Even-lwx/Triple-1S-Battery-Charger/code/connectivity-check.md

# 连通性复核

解析器版本 1：读取 Altium OLE 记录、原理图 RECORD=27 导线，以及 PCB Pads6 二进制网络/元件引用。
这里只使用单页整数几何关系。PCB 结果仅用于独立复核焊盘和网络，电气功能仍需结合芯片数据手册确认。

- U2.1 PC13: 原理图=PC13; PCB=PC13; 一致; UID=YJEDCGPU
- U2.2 PC14-OSC32_IN: 原理图=unnamed; PCB=未连接; 未命名; UID=EMMYZKTZ
- U2.3 PC15-OSC32_OUT: 原理图=unnamed; PCB=未连接; 未命名; UID=YTNMWNVS
- U2.4 VBAT: 原理图=3V3; PCB=3V3; 一致; UID=XNZBAPYZ
- U2.5 VREF+: 原理图=3V3; PCB=3V3; 一致; UID=BXHLKROT
- U2.6 VDD/VDDA: 原理图=3V3; PCB=3V3; 一致; UID=DLKCWMLF
- U2.7 VSS/VSSA: 原理图=GND; PCB=GND; 一致; UID=IMOANLTL
- U2.8 PF0-OSC_IN: 原理图=unnamed; PCB=NetC5_1; 未命名; UID=NLGOGNUO
- U2.9 PF1-OSC_OUT: 原理图=unnamed; PCB=NetC10_2; 未命名; UID=NNXCCHOH
- U2.10 PF2-NRST: 原理图=NRST; PCB=NRST; 一致; UID=FTIKCTVL
- U2.11 PA0: 原理图=ADC1_IN0; PCB=ADC1_IN0; 一致; UID=BTTNBYLP
- U2.12 PA1: 原理图=ADC1_IN1; PCB=ADC1_IN1; 一致; UID=DWYZLZNQ
- U2.13 PA2: 原理图=ADC1_IN2; PCB=ADC1_IN2; 一致; UID=QWPJPJDA
- U2.14 PA3: 原理图=ADC1_IN3; PCB=ADC1_IN3; 一致; UID=YGVUCJJT
- U2.15 PA4: 原理图=ADC1_IN4; PCB=ADC1_IN4; 一致; UID=QVMMUHNP
- U2.16 PA5: 原理图=ADC1_IN5; PCB=ADC1_IN5; 一致; UID=BHYGJPWF
- U2.17 PA6: 原理图=ADC1_IN6; PCB=ADC1_IN6; 一致; UID=GSTGELWS
- U2.18 PA7: 原理图=ADC1_IN7; PCB=ADC1_IN7; 一致; UID=QSPUCRNU
- U2.19 PB0: 原理图=unnamed; PCB=未连接; 未命名; UID=MEIPMAVJ
- U2.20 PB1: 原理图=unnamed; PCB=未连接; 未命名; UID=IZIHLWRI
- U2.21 PB2: 原理图=unnamed; PCB=未连接; 未命名; UID=KPNJPDPE
- U2.22 PB10: 原理图=PB10; PCB=PB10; 一致; UID=ZUVCRTMJ
- U2.23 PB11: 原理图=PB11; PCB=PB11; 一致; UID=TDTFGGSF
- U2.24 PB12: 原理图=PB12; PCB=PB12; 一致; UID=XKXEDOHT
- U2.25 PB13: 原理图=PB13; PCB=PB13; 一致; UID=AGJNDDFJ
- U2.26 PB14: 原理图=PB14; PCB=PB14; 一致; UID=OEQSESRP
- U2.27 PB15: 原理图=PB15; PCB=PB15; 一致; UID=NZOHDMBE
- U2.28 PA8: 原理图=unnamed; PCB=未连接; 未命名; UID=WIMFFKBL
- U2.29 PA9: 原理图=USART1_TX; PCB=USART1_TX; 一致; UID=NCBLJZFQ
- U2.30 PC6: 原理图=unnamed; PCB=未连接; 未命名; UID=YKQCQAAE
- U2.31 PC7: 原理图=unnamed; PCB=未连接; 未命名; UID=SIREAZQO
- U2.32 PA10: 原理图=USART1_RX; PCB=USART1_RX; 一致; UID=EFQVRADD
- U2.33 PA11[PA9]: 原理图=SPI1_MISO; PCB=SPI1_MISO; 一致; UID=DEECQGFN
- U2.34 PA12[PA10]: 原理图=SPI1_MOSI; PCB=SPI1_MOSI; 一致; UID=TXISVZNW
- U2.35 PA13: 原理图=SWDIO; PCB=SWDIO; 一致; UID=HHMXTXLN
- U2.36 PA14-BOOT0: 原理图=SWCLK; PCB=SWCLK; 一致; UID=LNGEJKZY
- U2.37 PA15: 原理图=unnamed; PCB=未连接; 未命名; UID=HMZLWYNL
- U2.38 PD0: 原理图=unnamed; PCB=未连接; 未命名; UID=CDKCRYSF
- U2.39 PD1: 原理图=PD1; PCB=PD1; 一致; UID=RTOJNFKF
- U2.40 PD2: 原理图=PD2; PCB=PD2; 一致; UID=TRQDABEJ
- U2.41 PD3: 原理图=PD3; PCB=PD3; 一致; UID=YJKJACAJ
- U2.42 PB3: 原理图=SPI1_SCK; PCB=SPI1_SCK; 一致; UID=TBVPMIWN
- U2.43 PB4: 原理图=PB4; PCB=PB4; 一致; UID=UAMPWPLB
- U2.44 PB5: 原理图=PB5; PCB=PB5; 一致; UID=CTSFHKLA
- U2.45 PB6: 原理图=PB6; PCB=PB6; 一致; UID=ZBDHNJFP
- U2.46 PB7: 原理图=PB7; PCB=PB7; 一致; UID=TEQMKVTK
- U2.47 PB8: 原理图=PB8; PCB=PB8; 一致; UID=UDJZPONJ
- U2.48 PB9: 原理图=PB9; PCB=PB9; 一致; UID=YJGGJVBI
- U5.1 IN: 原理图=5V_1; PCB=5V_1; 一致; UID=FEXVTGQE
- U5.2 ISET: 原理图=unnamed; PCB=NetR20_2; 未命名; UID=WSPMRYCQ
- U5.3 VSS: 原理图=GND; PCB=GND; 一致; UID=QGELADCW
- U5.4 PRETERM: 原理图=unnamed; PCB=NetR19_2; 未命名; UID=XNBEBDPG
- U5.5 PG#: 原理图=unnamed; PCB=NetLED1_1; 未命名; UID=PPBXFOSY
- U5.6 NC: 原理图=unnamed; PCB=未连接; 未命名; UID=SQTLGJFR
- U5.7 ISET2: 原理图=PB10; PCB=PB10; 一致; UID=BYBYBBMB
- U5.8 CHG#: 原理图=unnamed; PCB=NetLED3_1; 未命名; UID=CAYGFLDT
- U5.9 TS: 原理图=unnamed; PCB=NetR12_1; 未命名; UID=CIXCXFLB
- U5.10 OUT: 原理图=VBAT1_H; PCB=VBAT1_H; 一致; UID=NFSJJRQO
- U5.11 EP: 原理图=GND; PCB=GND; 一致; UID=HKDDBQFO
- U7.1 IN: 原理图=5V_2; PCB=5V_2; 一致; UID=OHIXYFKE
- U7.2 ISET: 原理图=unnamed; PCB=NetR37_2; 未命名; UID=HQWBLRSN
- U7.3 VSS: 原理图=GND; PCB=GND; 一致; UID=KROUAISZ
- U7.4 PRETERM: 原理图=unnamed; PCB=NetR36_2; 未命名; UID=KYNVKFRO
- U7.5 PG#: 原理图=unnamed; PCB=NetLED7_1; 未命名; UID=TOYUEIHO
- U7.6 NC: 原理图=unnamed; PCB=未连接; 未命名; UID=KDYSISUF
- U7.7 ISET2: 原理图=PB11; PCB=PB11; 一致; UID=ACEJQXMG
- U7.8 CHG#: 原理图=unnamed; PCB=NetLED8_1; 未命名; UID=PINZSOUC
- U7.9 TS: 原理图=unnamed; PCB=NetR31_1; 未命名; UID=YHHWTXJB
- U7.10 OUT: 原理图=VBAT2_H; PCB=VBAT2_H; 一致; UID=KZJXJZRR
- U7.11 EP: 原理图=GND; PCB=GND; 一致; UID=EHVHBIXW
- U9.1 IN: 原理图=5V_3; PCB=5V_3; 一致; UID=YEZHMSGT
- U9.2 ISET: 原理图=unnamed; PCB=NetR48_2; 未命名; UID=JKAMOJPK
- U9.3 VSS: 原理图=GND; PCB=GND; 一致; UID=LMYVFLJL
- U9.4 PRETERM: 原理图=unnamed; PCB=NetR46_2; 未命名; UID=UUAOIMHX
- U9.5 PG#: 原理图=unnamed; PCB=NetLED9_1; 未命名; UID=LRNTAKOZ
- U9.6 NC: 原理图=unnamed; PCB=未连接; 未命名; UID=TUCOUPCO
- U9.7 ISET2: 原理图=PB12; PCB=PB12; 一致; UID=XCBYYWYM
- U9.8 CHG#: 原理图=unnamed; PCB=NetLED10_1; 未命名; UID=UNNRSRKW
- U9.9 TS: 原理图=unnamed; PCB=NetR42_1; 未命名; UID=DDBXVVJB
- U9.10 OUT: 原理图=VBAT3_H; PCB=VBAT3_H; 一致; UID=YYCLJVQF
- U9.11 EP: 原理图=GND; PCB=GND; 一致; UID=SLRGLIYP
- U4.1 OUT: 原理图=unnamed; PCB=NetR9_1; 未命名; UID=RASYQZGU
- U4.2 GND: 原理图=GND; PCB=GND; 一致; UID=UNKJLNHE
- U4.3 IN+: 原理图=VBAT1_H; PCB=VBAT1_H; 一致; UID=VXHLWOPP
- U4.4 IN-: 原理图=VBAT1; PCB=VBAT1; 一致; UID=MJPIPOPB
- U4.5 V+: 原理图=3V3; PCB=3V3; 一致; UID=LBQMCPPH
- U6.1 OUT: 原理图=unnamed; PCB=NetR33_1; 未命名; UID=ELKXZWAX
- U6.2 GND: 原理图=GND; PCB=GND; 一致; UID=MDNJGTJA
- U6.3 IN+: 原理图=VBAT2_H; PCB=VBAT2_H; 一致; UID=MIHAALCZ
- U6.4 IN-: 原理图=VBAT2; PCB=VBAT2; 一致; UID=NVSDBFJM
- U6.5 V+: 原理图=3V3; PCB=3V3; 一致; UID=SGWFFXVR
- U8.1 OUT: 原理图=unnamed; PCB=NetR43_1; 未命名; UID=SQARUSVU
- U8.2 GND: 原理图=GND; PCB=GND; 一致; UID=CDSFDZOU
- U8.3 IN+: 原理图=VBAT3_H; PCB=VBAT3_H; 一致; UID=VEUORERN
- U8.4 IN-: 原理图=VBAT3; PCB=VBAT3; 一致; UID=EPCCTLHR
- U8.5 V+: 原理图=3V3; PCB=3V3; 一致; UID=ZDONUWIX
- U3.1 1: 原理图=GND; PCB=GND; 一致; UID=NTNGKQDQ
- U3.2 2: 原理图=3V3; PCB=3V3; 一致; UID=ZHRGQOSQ
- U3.3 3: 原理图=SPI1_SCK; PCB=SPI1_SCK; 一致; UID=ARPVTTBJ
- U3.4 4: 原理图=SPI1_MOSI; PCB=SPI1_MOSI; 一致; UID=GFGQCWLM
- U3.5 5: 原理图=PD1; PCB=PD1; 一致; UID=ZEEPJUFZ
- U3.6 6: 原理图=PD2; PCB=PD2; 一致; UID=NZBXZJHM
- U3.7 7: 原理图=PD3; PCB=PD3; 一致; UID=MSIVUSRT

已独立匹配的关键命名引脚：70 个。未命名网络需要结合 inspect_schematic.py 输出的成员列表，不能仅凭网络名称匹配证明连接关系。
