Even-lwx/Triple-1S-Battery-Charger/code/README-bringup.md

# 三路 1S 充电器初始化与上板验收

实现日期：2026-10-28。STM32G031C8T6，HSI/PLL 64 MHz，STM32 HAL G0 V1.6.3。
按 embedded-project-planner 工作流实施；保留原工程，未改写 pcb/doc，未创建新提交。

## 上电行为

1. HAL、时钟初始化；USART1 PA9/TX、PA10/RX，115200、8N1。
2. 初始化按键、LED、OLED 控制和 ISET2 GPIO，逐项输出 `[INIT] ... OK/FAIL code=...`。
3. SPI1 模式0、MSB先发、1MHz；ADC1 时钟16MHz，160.5周期采样，执行校准。
4. SSD1306 128×64 初始化并显示启动页。型号与7P针序已由用户确认；128×64分辨率按常见0.96寸模块配置，需实物核验。
5. GPIO启动先置三路ISET2悬空100mA，随后从Flash恢复上次保存的三路设定；无有效记录时保持100mA，逐路记录初始化结果。
6. 首次采样后每秒刷新输入电压、三路电池电压、电流、设定电流；串口另外输出 VDDA、NTC 原始码与电压范围状态。

显示中的 ISET 是设定档位，B1/B2/B3 的 MA 是实际 ADC 测量值。
PG/CHG 只接板载 LED，没有接 MCU，程序不能宣称“充满”或准确识别电池存在。
LOW/OPEN 只表示低电压或空载疑似状态。输入4.4–5.5V、电池2.5–4.25V仅用于调试分档，不能替代充电保护。

## 引脚与换算依据

原文件：`pcb/Triple 1S Battery Charger/Sheet1.SchDoc`，PCB：同目录 `PCB1.PcbDoc`。
连通性解析见 `tools/inspect_schematic.py`，命名引脚与独立 PCB 焊盘网络的70项比对见 `connectivity-check.md`。
原理图导线实际是 RECORD=27；RECORD=6 是图形折线。OwnerIndex 不含文件头，外部引脚连接点需按 PinLength 和方向计算。
脚本仅验证本工程的单页整数坐标几何，不能直接宣称支持任意多页层次原理图、总线或分数坐标。

| 功能 | 原理图器件/网络 | MCU |
| --- | --- | --- |
| 电池1电压/电流 | R8/R13、U4 INA180A3，ADC1_IN0/1 | PA0/PA1 |
| 电池2电压/电流 | R32/R34、U6 INA180A3，ADC1_IN2/3 | PA2/PA3 |
| 电池3电压/电流 | R40/R44、U8 INA180A3，ADC1_IN4/5 | PA4/PA5 |
| 输入电压 | R3/R6，经R4，ADC1_IN6 | PA6 |
| NTC | R2/R5，ADC1_IN7 | PA7 |
| 三路ISET2 | U5/U7/U9 pin7，PB10/PB11/PB12 | PB10/11/12 |
| OLED GND/VCC/SCL/SDA | U3 pin1/2/3/4 | GND/3V3/PB3/PA12 |
| OLED RES/DC/CS | U3 pin5/6/7 | PD1/PD2/PD3 |
| 按键1/2/3/复位档位 | SW4/SW3/SW2/SW5，低有效，外部上拉 | PB4/5/6/7 |
| 指示灯 | LED4/5/6，低有效 | PC13/PB8/PB9 |

电池分压47k/10k：Vbat=Vadc×5.7。输入分压100k/47k：Vin=Vadc×147/47。
INA180A3增益100，R17/R38/R47为30mΩ：I(mA)=Vadc(mV)/3。
VREFINT出厂校准值换算实时VDDA；每通道先丢弃一次，再平均8次。PA7只报告原始码，NTC曲线未核实前不输出虚构温度。
模拟电流通道不能测负向电流，也不能通过读取ADC证明INA芯片存在；需负载实测零偏与增益。

## 三档电流与按键

| 档位 | ISET2电平/模式 | 实际含义 |
| --- | --- | --- |
| 100mA | 无上下拉输入/悬空 | BQ24040低电流档 |
| 500mA | 推挽高 | BQ24040中电流档 |
| 1000mA标称 | 推挽低 | 电阻设定档；图中560Ω按540/R计算约964mA |

四键菜单已替代直接切档：PB4=上，PB5=下，PB6=确认，PB7=返回。
总览用上下选择通道，确认进入详情；详情确认进入菜单，总览返回也可打开菜单。
菜单包括电流设置、三路恢复100mA、说明页。电流设置上下移动光标，确认才应用，返回取消。
软件30ms消抖，长按不重复；同时按键忽略，返回键优先取消；开机按住不会直接改变档位。
1.5秒电池启动动画可由任意键跳过，跳过的按键不会改变电流；动画期间继续采样。
从500mA恢复悬空时直接切输入，不先拉低，避免过渡到电阻设定的最大电流档。
`Board_SetCurrent()` 返回明确结果，`Board_GetCurrent()` / `Board_CurrentMA()` 查询软件设定。

ISET2没有“关闭充电”功能。原图 TS pin9 各接10k到地，PG/CHG只接LED。
为防上层误用，`Board_SetChargeEnabled()` 两种请求均明确返回 `BOARD_UNSUPPORTED` 并记录原因，且不改变GPIO。
默认100mA仍然允许充电，MCU复位期间也无法靠固件停止充电。
充电器自身的恒流恒压、热调节与输入限流可能使实际充电电流低于所选档位。

## 数据手册

- TI BQ24040，SLUS941H，2021-02修订，印刷p4引脚表、p19 §8.4.7 ISET2：LOW为电阻设定、HIGH最高500mA、悬空最高100mA；三种均允许充电。https://www.ti.com/lit/ds/symlink/bq24040.pdf
- TI INA180，SBOS741H，2022-07，p1及增益表：A3=100V/V。https://www.ti.com/lit/ds/symlink/ina180.pdf
- SSD1306 Rev1.1，2008-04，p17 §8.1.3：SPI上升沿移位、串行接口只能写；§9/10命令及初始化。https://cdn-shop.adafruit.com/datasheets/SSD1306.pdf
- ADC排序/校准/VREFINT依据工程自带 `stm32g0xx_hal_adc.c`、`stm32g0xx_hal_adc_ex.h`、`stm32g0xx_ll_adc.h`，rank1替换通道，不累计旧通道。

原理图输入串联 R10/R30/R41 的显示值与料号有冲突（显示0Ω，RE1206F1R000可能为1Ω），上板应核对阻值，避免误判压降与发热。

## 错误与诊断

初始化失败输出阶段和状态码。GPIO成功表示寄存器配置读回一致；OLED成功只表示SPI传输完成，没有屏幕读回应答。
ADC校准失败不进入采样，采集超时、VREF异常或电流ADC饱和时整帧无效，清除valid并在OLED显示错误，不继续显示旧数值。
OLED刷新失败记录错误并停止后续刷新；输入/电流监测和串口继续。三个MCU LED现专用于对应三路充电估计状态，PC13不再作为全局数据有效指示。
USART自身失败或早期时钟失败会进入停止路径，调试器读取 `board_fault.stage/code/uart_errors`。
该记录仅当前启动有效，不承诺复位后保留；没有串口时不虚称已发出串口消息。
HAL发送有超时，日志接口仅供主循环调用，不可用于IRQ/多任务并发。

## 工程、构建与验证

打开 `MDK-ARM/code.uvprojx`，自建库在 `code/Hardware/`，已加入实际工程分组与头文件路径。
Keil栈调整为2KB；CubeMX引脚模型已修正PB7为输入，并补齐PB4/PB10/11/12/PC13，SPI/ADC参数同步。
**CubeMX重新生成会覆盖部分手动修改**：`MX_*_Init`返回HAL状态、main中串口优先初始化、GPIO适配入口、Keil新增分组等需要保留/重新集成；不能直接用重新生成的void接口覆盖后继续构建。

本机 ARM Compiler5 缺少许可证，尚未验证Keil编译。额外提供GCC构建脚本，不修改PCB或源文件：

```powershell
python code/tools/build_gcc.py --compiler '<arm-none-eabi-gcc.exe完整路径>'
python code/tools/test_firmware.py
```

GCC读取Keil中的同一份C源码列表，使用ST官方GCC启动文件；64KB物理Flash中60KB供程序、4KB供配置，RAM为8KB。
产物在 `code/_reports/gcc/charger.elf/.hex/.bin`。GCC编译启用Wall/Wextra/Werror，已编译链接通过。
nosys标准库的文件读写桩及裸机RWX段有链接提示；不使用文件IO，串口走HAL，不宣称整个链接零警告。
仿真测试依赖 `unicorn`、`pyelftools`，执行真实Thumb固件并替换HAL入口，不替代板上外设验证。
覆盖：分压与增益换算、通道切换、超时后停止ADC、无效参考/饱和、三档GPIO、悬空无低脉冲、按键消抖/保持/复位优先、OLED失败释放CS、串口失败RAM记录、禁用接口不误动作。

### 上板验收（尚未执行）

1. USART1 TX(PA9)接3.3V USB串口RX并共地；确认上电每项INIT及失败码。检查SSD1306启动页/刷新和实际分辨率。
2. 万用表测输入、三路电池分压点、3V3，与串口值逐路比较；确认R10等实际阻值和30mΩ分流电阻。
3. 每路从100mA开始，用受控电池/负载及电流表验证三个档位与按键顺序，确认PB10/11/12浮/高/低；额定1A档核对实测电流和热调节。
4. 断开屏幕验证“SPI可能仍成功”的局限；在调试器故障注入HAL超时验证日志和OLED错误路径，USART初始化失败读取board_fault。
5. 低输入、空电池口、ADC饱和和重新上电验证不会报告虚构“充满/电池存在”。本PCB无法执行软件关断，100mA不是关闭。

## 界面升级与估算限制

新增 `ui.c/ui.h` 管理菜单状态，`oled.c` 增加坐标绘图、倍大字、反色区域和电池图形。
总览、单路详情、电流编辑、菜单、说明页和ADC异常状态均已实现；动画10Hz，采样1Hz，没有阻塞式启动动画。
128×64空间有限，采用英文短标签；`V-EST`表示电压估计。实测电流≥20mA且电压合理时显示移动光条，仅表示电流读数，不能确认充电器CHG状态。
进度条使用未经具体电芯标定的4.2V锂电压代理曲线：3000/3300/3500/3600/3700/3800/3900/4000/4100/4200mV对应0/5/10/20/35/55/70/80/90/99%。
充电压升、温度和电芯差异会造成偏差，不能用于保护判断；数据无效或超出2.5–4.25V时显示未知，最高99%，不会仅凭电压宣称充满。
根据用户确认，容量不固定，**不加入容量设置，也不估算充满时间**。电流档位现在保存到Flash，上电恢复，详见下节。

GCC重新编译链接通过，菜单仿真覆盖消抖、长按、取消、确认应用和全部恢复100mA，另覆盖估算边界及单调性。
执行 `python code/tools/preview_ui.py` 直接调用Thumb固件绘图代码，从真实1024字节帧缓冲生成PNG预览，输出 `code/_reports/ui/`。
预览使用仿真输入，不是实板测量；已检查各页面排版。仍需上板核验字体、刷新、四键顺序和实际档位切换。

## 三路LED与预设电流显示

LED4/PC13=通道1，LED5/PB8=通道2，LED6/PB9=通道3，均为低电平点亮。
`charge_led.c` 独立管理状态和非阻塞1Hz闪烁（500ms亮/500ms灭）。用户实测空载约1mA，暂按下列门限，需上板校准：

- ≤3mA持续3秒：熄灭，清除此前充电记录。
- ≥8mA持续2秒：闪烁，记录本次曾检测到充电电流。
- 曾进入闪烁状态，且电压≥4.15V、电流>3mA并≤max(10mA,预设电流/10)，持续30秒：常亮，仅表示“疑似充满”。
- 3–8mA的非满电候选区间维持原指示以减少抖动；数据失效、输入不在4.4–5.5V或电池电压不在2.5–4.25V时立即熄灭并清除历史。

空载优先：充满后的电流若也降到≤3mA，同样会熄灭，不能与拔掉电池可靠区分。
空载脉冲、并联负载、ADC零偏或低输入均可能影响推断。常亮不是BQ24040终止充电信号确认；准确判断仍需额外CHG/在位反馈。
开机直接插入已满电池且没有检测到明确充电电流，不直接宣称满电。状态变化串口输出EMPTY/UNKNOWN、CHARGING-EST或FULL-EST。

总览表头 `V I/SET MA` 表示电压及“实测电流/预设电流”，例如 `3.79 483/1000`。
单路详情另设 `SET 1000MA`，即使ADC异常或存在输入警告也显示预设值。1000mA仍是名义电阻档。
新增LED仿真覆盖低有效引脚映射、闪烁相位、空载优先、持续时间、充满候选和无效数据清除；合计10项测试通过，尚未上板验收门限。

## 电流档位掉电保存

`settings.c/settings.h` 使用STM32G031C8最后两页（page30/31，各2KB），地址 `0x0800F000–0x0800FFFF`。
GCC链接脚本和Keil IROM均缩减为60KB（结束于0x0800EFFF），禁止程序占用配置区；后续CubeMX重新生成工程时必须保留此限制。
依据工程自带 `stm32g0xx_hal_flash.h` 的FLASH_PAGE_SIZE=0x800及DOUBLEWORD编程类型，HAL Flash/FlashEx完成写入。

- 菜单确认单路电流：三路档位打包保存，校验通过后应用GPIO；取消编辑不写入。
- 菜单“三路恢复100mA”：同样保存，复位后保持100mA。
- 档位未变化且已有相同记录：不重复写入。每次有效变化只追加16字节，单页128条；满页后擦除另一页并轮换。
- 记录包含格式版本、递增序号、三路档位、CRC32和最后写入的提交标记。写入失败不切换到新电流，菜单保留编辑页并显示SAVE FAILED SEE UART。
- 启动扫描两页选择最新有效记录；空白、版本不兼容、CRC损坏或档位非法记录跳过，完全无有效记录默认100mA。
- 换页先保留旧页，再擦另一页、写入和校验新记录；在正常Flash读回条件下，未提交记录不会替代旧记录。真正掉电中断编程可能涉及ECC/电压问题，仍须实板掉电测试，不宣称仿真覆盖物理故障。
- 串口输出FLASH LOAD/FLASH SAVE以及HAL错误码，保存失败不会被静默报告为成功。

普通断电重启保留设置，但整片擦除/全片下载会清掉配置；调试下载应选择仅擦应用使用的页，并确认工具不擦page30/31。
Flash保存会短暂阻塞主循环，LED/动画可能暂停数十毫秒；不在中断中写Flash，不修改选项字节。
恢复1000mA表示恢复上次选择的名义电流档位，复位初期仍为悬空100mA，且BQ24040自身限流/热调节仍有效。

新增真实Thumb仿真覆盖：三路独立恢复、相同值无重复写、提交中断回退、跨页换页保留旧记录、CRC损坏回退及全部100mA保存。
上板需要逐路设为不同档位后断电、重启验证串口/GPIO/OLED一致，并测试保存时断电及Flash写保护失败提示。
