Even-lwx/Triple-1S-Battery-Charger/(list of files, drawings)

Other design files:
pcb/Triple 1S Battery Charger/PCB1.PcbDoc
pcb/Triple 1S Battery Charger/Sheet1.SchDoc
pcb/Triple 1S Battery Charger/Triple 1S Battery Charger.PrjPcb
