Even-lwx/Triple-1S-Battery-Charger/code/code.ioc

Mcu.UserName=STM32G031C8Tx
PA0.Signal=ADC1_IN0
PA1.Signal=ADC1_IN1
PA10.Signal=USART1_RX
PA13.Signal=SYS_SWDIO
PA14-BOOT0.Signal=SYS_SWCLK
PA2.Signal=ADC1_IN2
PA3.Signal=ADC1_IN3
PA4.Signal=ADC1_IN4
PA5.Signal=ADC1_IN5
PA6.Signal=ADC1_IN6
PA7.Signal=ADC1_IN7
PA9.Signal=USART1_TX
PB3.Signal=SPI1_SCK
PB5.Signal=GPIO_Input
PB6.Signal=GPIO_Input
PB7.Signal=GPIO_Input
PB8.Signal=GPIO_Output
PB9.Signal=GPIO_Output
PD1.Signal=GPIO_Output
PD2.Signal=GPIO_Output
PD3.Signal=GPIO_Output
PB4.Signal=GPIO_Input
PB10.Signal=GPIO_Input
PB11.Signal=GPIO_Input
PB12.Signal=GPIO_Input
PC13.Signal=GPIO_Output
