Even-lwx/Triple-1S-Battery-Charger/code/code/Hardware/ui.h

#ifndef CHARGER_UI_H
#define CHARGER_UI_H
#include "board.h"
/* PB4 向上、PB5 向下、PB6 确认、PB7 返回；每次处理一个消抖后的事件。 */
typedef enum { UI_UP=1, UI_DOWN=2, UI_OK=4, UI_BACK=8 } UIKey;
void UI_Init(uint32_t now);
void UI_Key(unsigned key);
void UI_Draw(const BoardTelemetry *data, uint32_t now);
int UI_VoltagePercent(uint32_t mv);
#endif
