Even-lwx/Triple-1S-Battery-Charger/(commit log)

2026-10-14 chore: establish project baseline
    [PCB1.PcbDoc, Sheet1.SchDoc, Triple 1S Battery Charger.PrjPcb]
2026-11-05 Initial project snapshot
    [Triple 1S Battery Charger.xlsx]
2026-11-05 Ignore generated project artifacts
    [Triple 1S Battery Charger.xlsx]
2026-11-05 将项目说明和注释统一为中文
2026-11-05 完善中文工程文档和注释
2026-11-06 更新三路单节锂电池充电板布局
    [PCB1.PcbDoc]
